sergiomokshin/Aquarinium/README.md

# Aquarinium

Projeto para automação de aquario

## Funcionalidades previstas
- Monitoração remota via WEB de todas as funções 
- Controle via keypad de todas as funções
- Monitor de Temperatura
- Monitor de PH
- Monitor de Nível de agua
- Configuração de timer para acendimento automático de luzes
- Relógio
- Dimmer com cores branca, vermelha, azul e verde
- 1 Saída programável
- Saída para termostato
- Saída para filtro / bomba
- Saída para luz branca

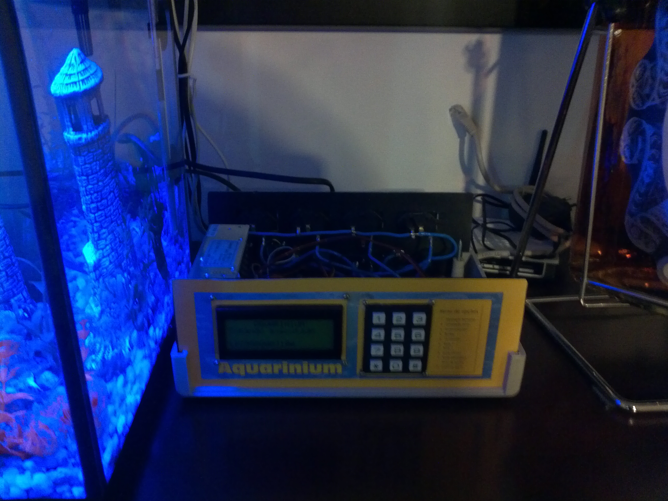
[picture p1: fotos/front.jpg]
Front


- Painel de comando com LCD para visualização de comandos, relógio e teclado para acesso as funções
Painel

- Fundo painel de comando
PainelFundo

- Diagrama de conexões
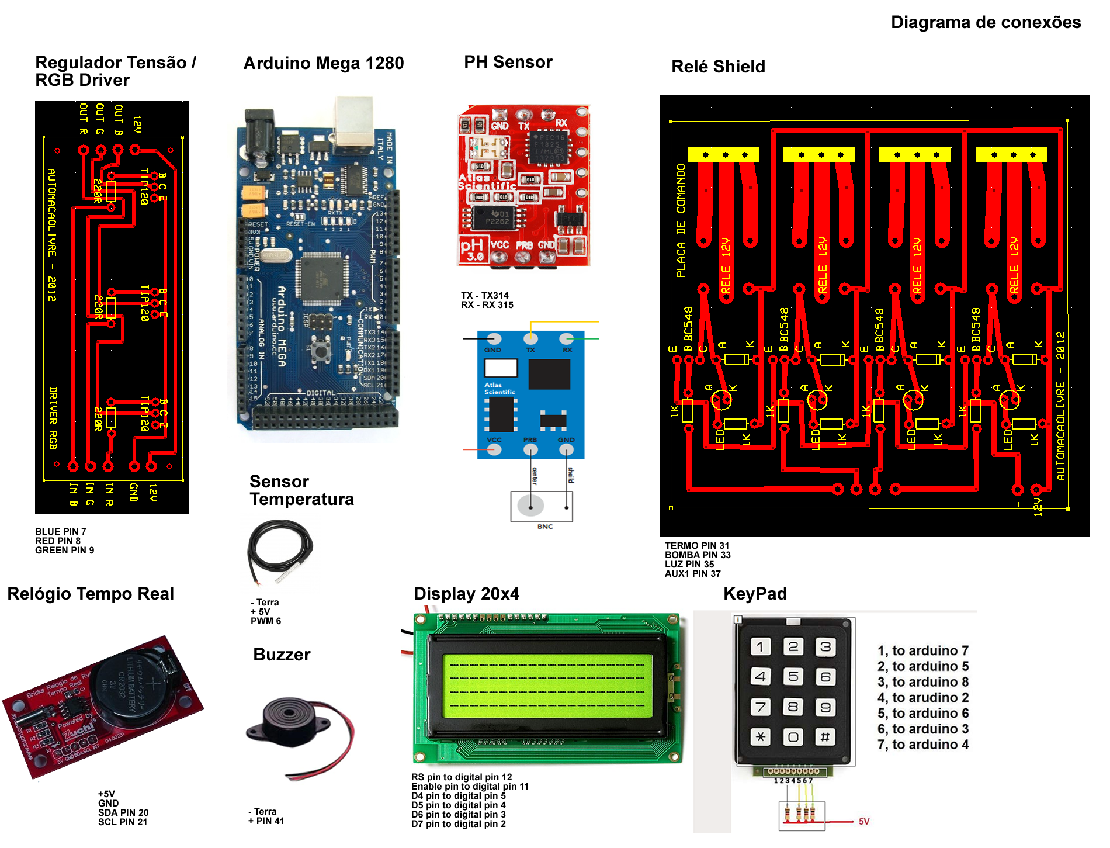
[picture p2: projeto/projeto.png]


## Lista de componentes
- 1 Arduino MEGA 128
- 1 Ethernet Shield
- 1 Relé Shield
-- 4 Relés 12V
-- 4 Transistores BC548
-- 4 Diodos 1N4004
-- 8 Resistores 1K 1/8W
-- 4 Leds 5mm
-- 3 Bornes KRE 2 vias
-- 4 Bornes KRE 3 vias
-- 1 placa circuito impresso
- 1 RGB Driver e Estabilizador de tensão
-- 3 Transistores TIP120
-- 3 Bornes KRE 2 vias
-- 1 Bornes KRE 3 vias
-- 3 Resistores 220R 1/8w
-- 1 placa circuito impresso
-- 1 LM7805
-- 1 LM 7809 com dissipador
- 1 Buzzer 12V
- 1 KeyPad
- 1 LCD 20x4
- RTC 
- Fonte chaveada 12V x 5A
- 1 Mt Fita de Led RGD

- Conexões
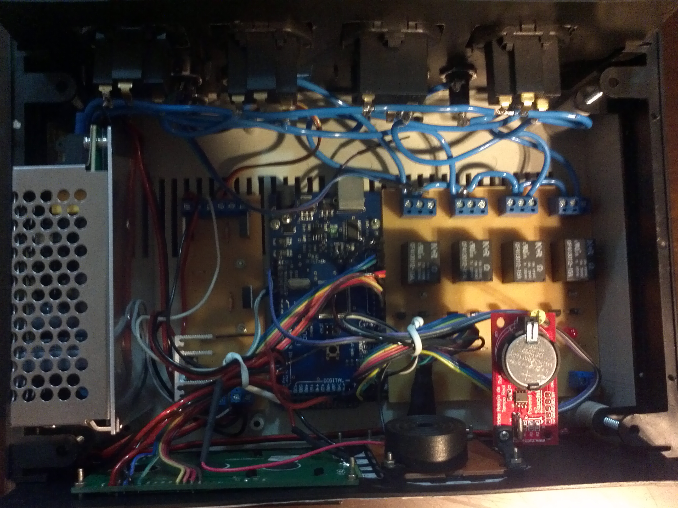
[picture p3: fotos/circuito.jpg]


- Relé Shield
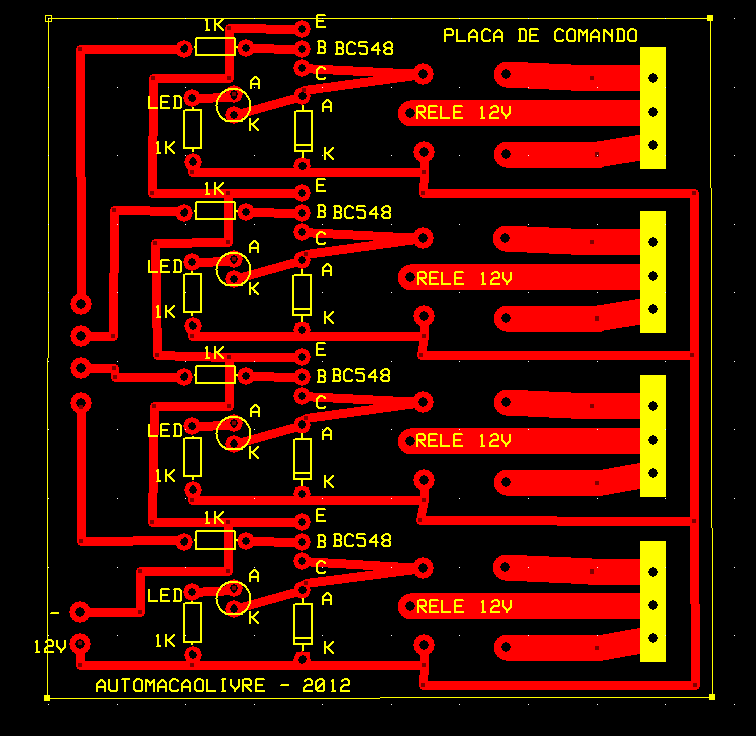
[picture p4: pcb_files/rele_shield.png]


- RGB Driver e Estabilizador de Tensão 5V e 9V
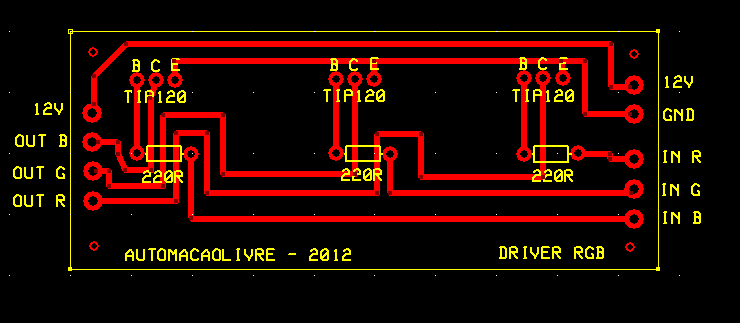
[picture p5: pcb_files/driver_rgb.png]
