sergiomokshin/Aquarinium/pcb_files/driver.png

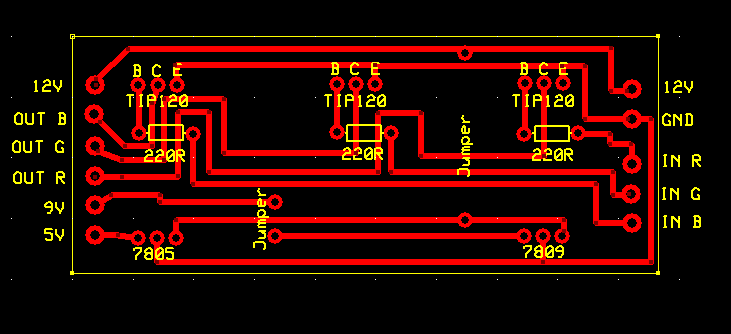
pcb_files/driver.png
