sergiomokshin/Aquarinium/projeto/fundo_controlador.png

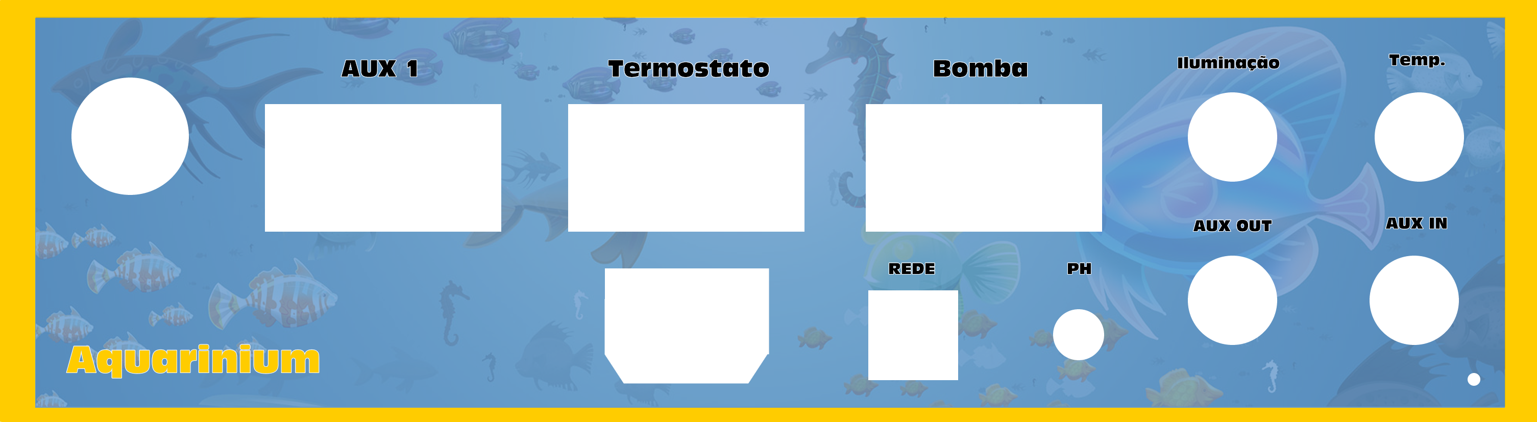
projeto/fundo_controlador.png
