sergiomokshin/Aquarinium/projeto/fundo_monitor.png

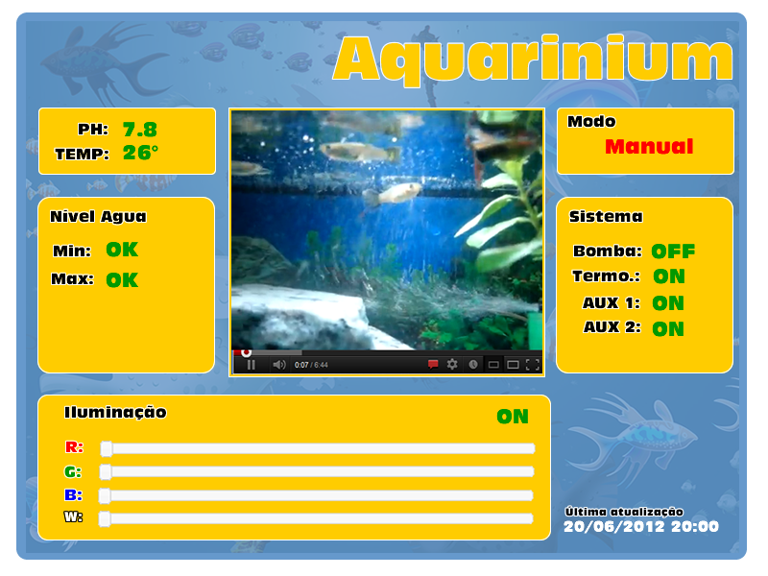
projeto/fundo_monitor.png
