sergiomokshin/Aquarinium/(list of files, drawings)

Other design files:
pcb_files/driver.pcb
pcb_files/driver_rgb.pcb
pcb_files/regulador_tensao.pcb
pcb_files/rele_shield.pcb
