sergiomokshin/Aquarinium/(commit log)

2012-06-23 Driver RGB
    [driver_rgb.pcb]
2012-06-23 Finalizacao placa Driver RGB
    [driver_rgb.pcb]
2012-06-24 Rele Shield
    [rele_shield.pcb]
2012-06-24 Faces cobreadas PCBs
2012-06-26 Webserver com comando para RGB
2012-06-29 Driver full
    [driver.pcb, regulador_tensao.pcb]
2012-10-10 Implementacao watchdog e monitoramento de temperatura
2012-10-24 Correcao horario de verao e nova programacao de iluminacao
2012-11-24 Leitura de PH
